kaidemler/trng/(commit log)

2016-03-17 Added a python script for ascii '10' conversion to byte data, directories for containing our samples vs. samples from other RNG's
2016-03-18 Arduino sampling program, two testfiles
